SHC-ASTRA/biosensor-electrical/LANCE/LANCE.kicad_pcb

## KiCad design LANCE/LANCE.kicad_pcb (2026-05-26)

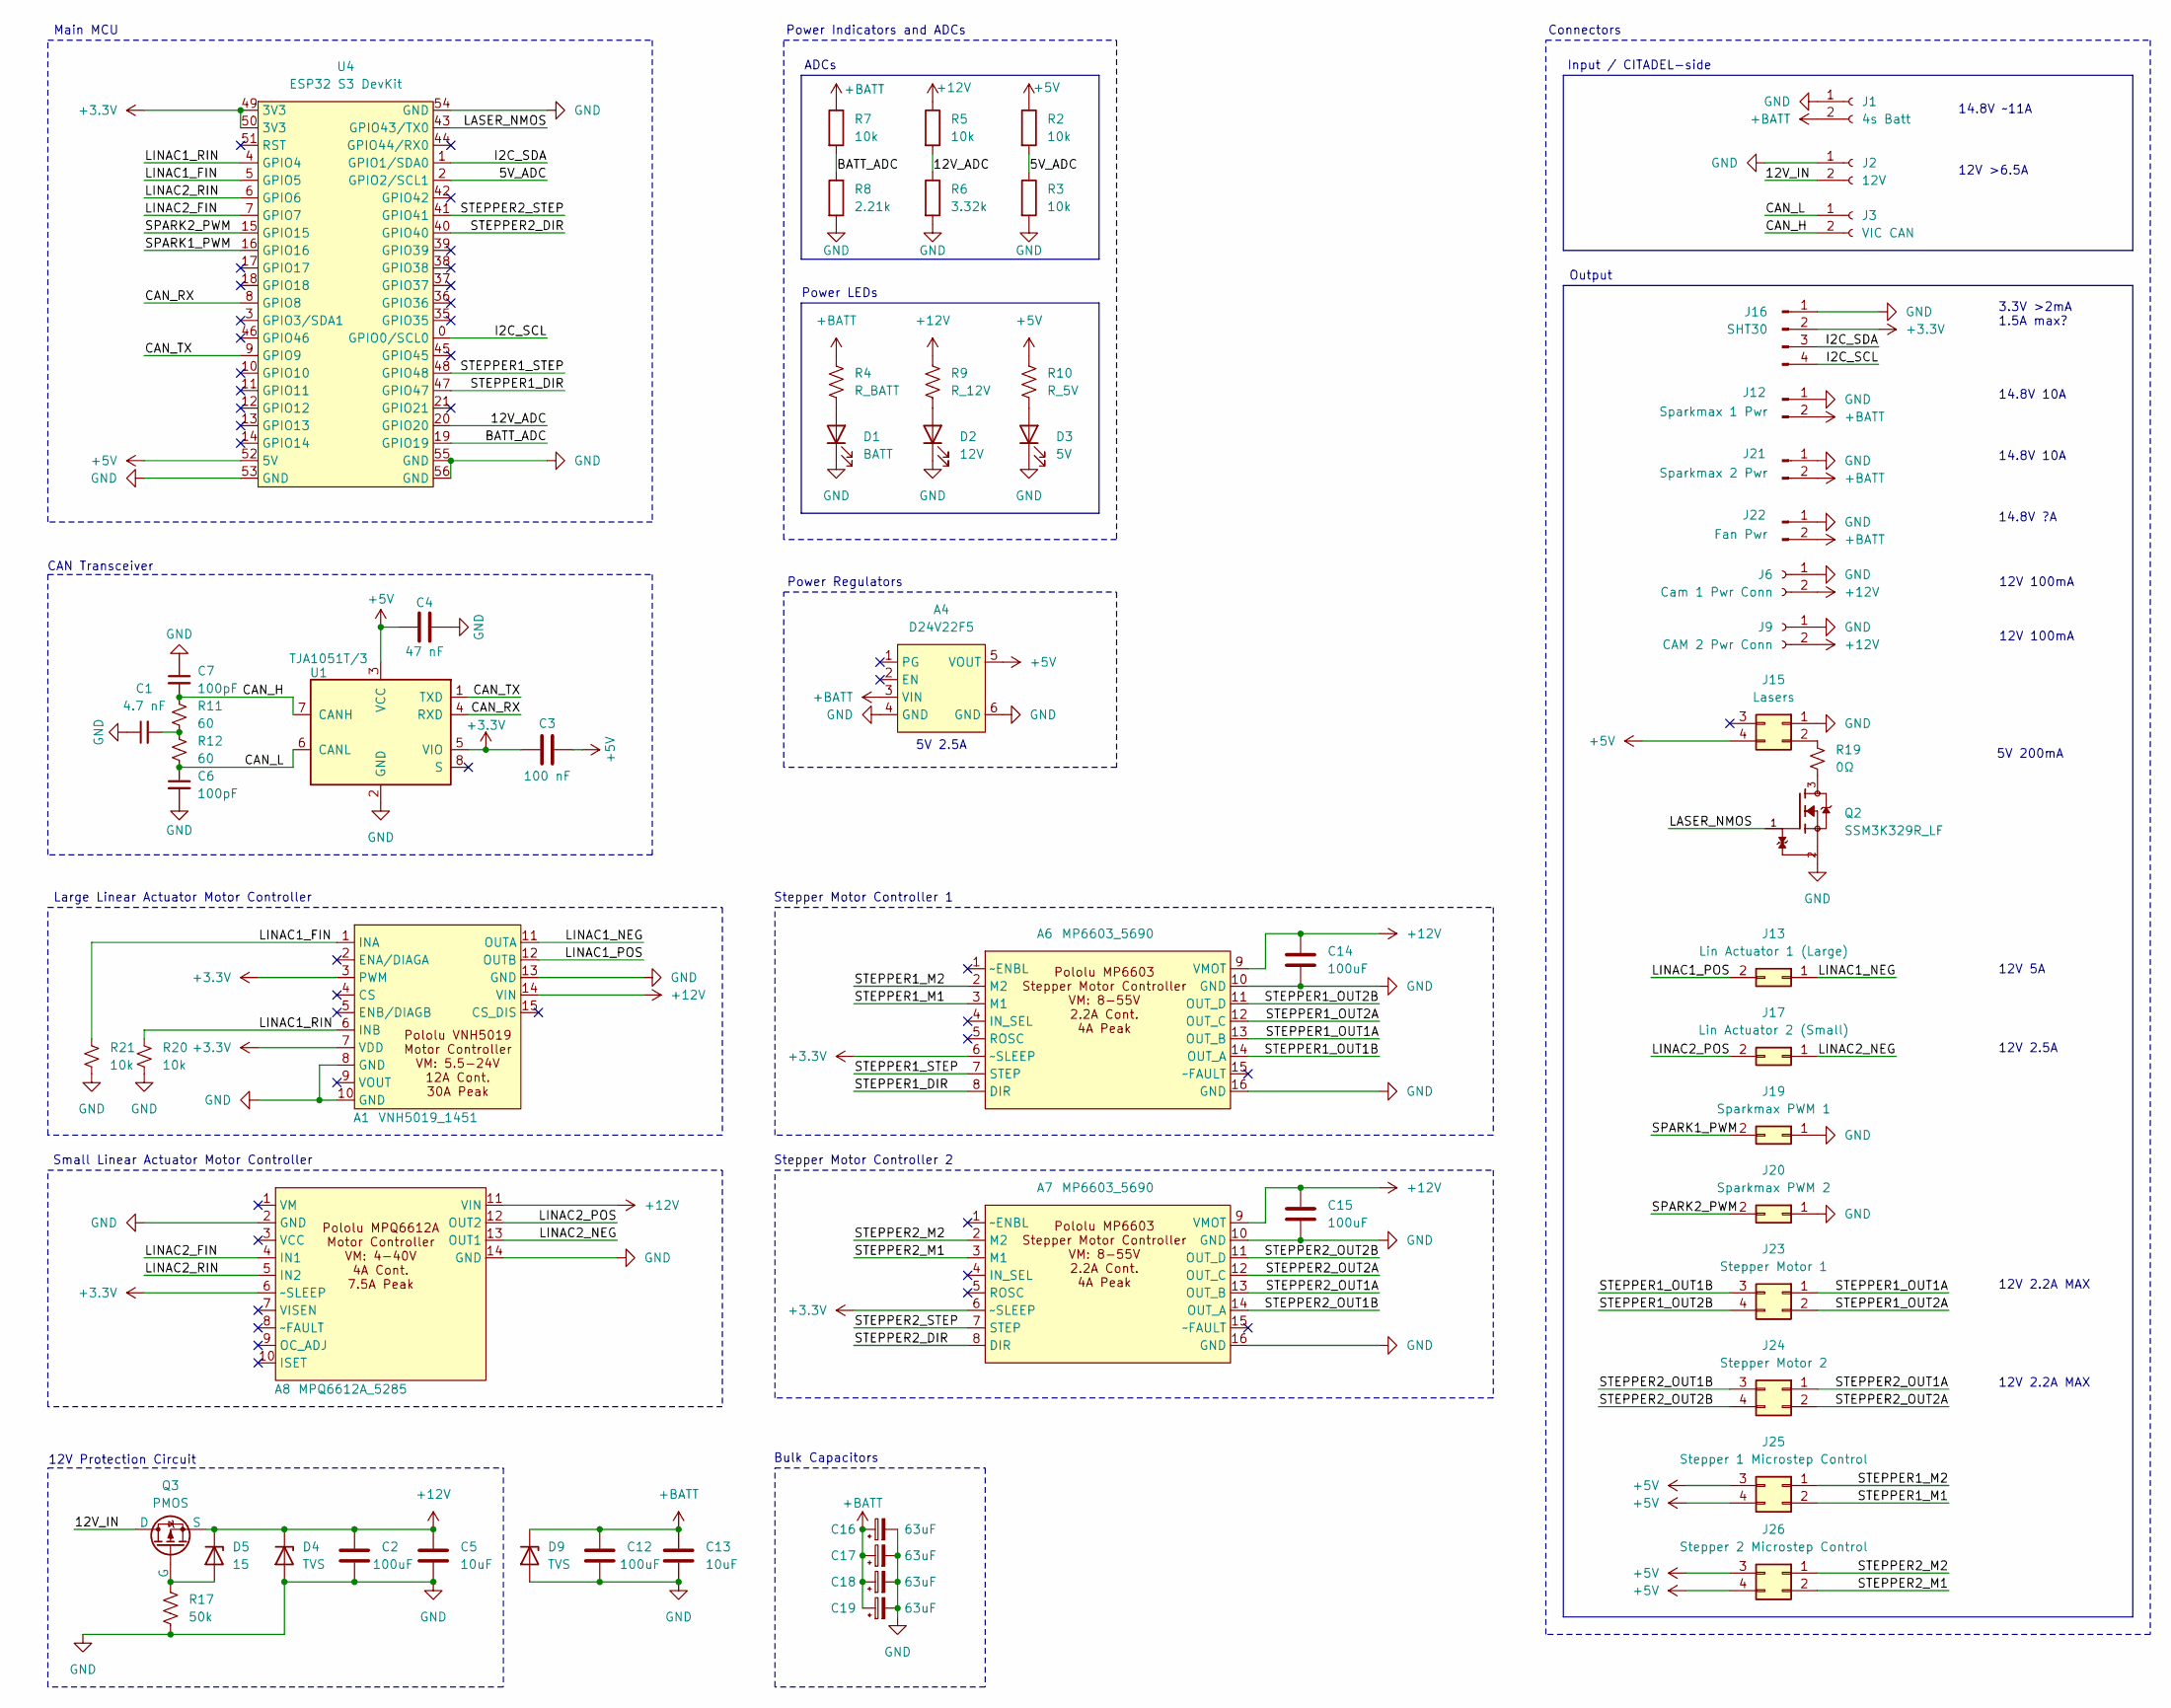
[picture p1: schematic LANCE.kicad_sch, LANCE 2026]

Parts:
A1: VNH5019_1451
A4: D24V22F5; D24V22Fx
A6, A7: MP6603_5690; MP6603-5690
A8: MPQ6612A_5285
C1: 4.7 nF; C_0603_1608Metric_Pad1.08x0.95mm_HandSolder
C2, C12, C14, C15: 100uF; C_1210_3225Metric_Pad1.33x2.70mm_HandSolder
C3: 100 nF; C_0603_1608Metric_Pad1.08x0.95mm_HandSolder
C4: 47 nF; C_0603_1608Metric_Pad1.08x0.95mm_HandSolder
C5, C13: 10uF; C_0603_1608Metric_Pad1.08x0.95mm_HandSolder
C6, C7: 100pF; C_0603_1608Metric_Pad1.08x0.95mm_HandSolder
C16, C17, C18, C19: 63uF; CP_Elec_6.3x7.7
D1: BATT; LED_0603_1608Metric_Pad1.05x0.95mm_HandSolder
D2: 12V; LED_0603_1608Metric_Pad1.05x0.95mm_HandSolder
D3: 5V; LED_0603_1608Metric_Pad1.05x0.95mm_HandSolder
D4, D9: TVS; SOD-323HEUS2H_TOS
D5: 15; D_SOD-123
J1: 4s Batt; AMASS_XT60PW-M_1x02_P7.20mm_Horizontal
J2: 12V; AMASS_XT30PW-M_1x02_P2.50mm_Horizontal
J3: VIC CAN; AMASS_XT30PW-F_1x02_P2.50mm_Horizontal
J6: Cam 1 Pwr Conn; AMASS_XT30U-F_1x02_P5.0mm_Vertical
J9: CAM 2 Pwr Conn; AMASS_XT30U-F_1x02_P5.0mm_Vertical
J12: Sparkmax 1 Pwr; AMASS_XT60PW-F_1x02_P7.20mm_Horizontal
J13: Lin Actuator 1 (Large); AMASS_XT30U-F_1x02_P5.0mm_Vertical
J15: Lasers; Molex_Mini-Fit_Jr_5566-04A_2x02_P4.20mm_Vertical
J16: SHT30; Molex_Mini-Fit_Jr_5566-04A_2x02_P4.20mm_Vertical
J17: Lin Actuator 2 (Small); AMASS_XT30U-F_1x02_P5.0mm_Vertical
J19: Sparkmax PWM 1; Molex_Mini-Fit_Jr_5566-02A_2x01_P4.20mm_Vertical
J20: Sparkmax PWM 2; Molex_Mini-Fit_Jr_5566-02A_2x01_P4.20mm_Vertical
J21: Sparkmax 2 Pwr; AMASS_XT60PW-F_1x02_P7.20mm_Horizontal
J22: Fan Pwr; AMASS_XT60PW-F_1x02_P7.20mm_Horizontal
J23: Stepper Motor 1; Molex_Mini-Fit_Jr_5566-04A_2x02_P4.20mm_Vertical
J24: Stepper Motor 2; Molex_Mini-Fit_Jr_5566-04A_2x02_P4.20mm_Vertical
J25: Stepper 1 Microstep Control; PinHeader_2x02_P2.54mm_Vertical
J26: Stepper 2 Microstep Control; PinHeader_2x02_P2.54mm_Vertical
Q2: SSM3K329R_LF; SOT-23F_TOS; PARTREV 1.0
Q3: PMOS; TO-252-2
R2, R3, R5, R7, R20, R21: 10k; R_0603_1608Metric_Pad0.98x0.95mm_HandSolder
R4: R_BATT; R_0603_1608Metric_Pad0.98x0.95mm_HandSolder
R6: 3.32k; R_0603_1608Metric_Pad0.98x0.95mm_HandSolder
R8: 2.21k; R_0603_1608Metric_Pad0.98x0.95mm_HandSolder
R9: R_12V; R_0603_1608Metric_Pad0.98x0.95mm_HandSolder
R10: R_5V; R_0603_1608Metric_Pad0.98x0.95mm_HandSolder
R11, R12: 60; R_0603_1608Metric_Pad0.98x0.95mm_HandSolder
R17: 50k; R_0603_1608Metric_Pad0.98x0.95mm_HandSolder
R19: 0Ω; R_0603_1608Metric_Pad0.98x0.95mm_HandSolder
U1: TJA1051T/3; SOIC-8_3.9x4.9mm_P1.27mm
U4: ESP32 S3 DevKit; ESP32-S3-DevKit_No_Keep-Out_Zone

Connections:
+3.3V: A1.3 (PWM), A1.7 (VDD), A6.6 (~SLEEP), A7.6 (~SLEEP), A8.6 (~SLEEP), C3.2, J16.2, U1.5 (VIO), U4.49 (3V3), U4.50 (3V3)
+5V: A4.5 (VOUT), C3.1, C4.1, J15.4, J25.3, J25.4, J26.3, J26.4, R2.1, R10.1, U1.3 (VCC), U4.52 (5V)
+12V: A1.14 (VIN), A6.9 (VMOT), A7.9 (VMOT), A8.11 (VIN), C2.1, C5.1, C14.1, C15.1, D4.1 (K), D5.1 (K), J6.2, J9.2, Q3.3 (S), R5.1, R9.1
+BATT: A4.3 (VIN), C12.1, C13.1, C16.1, C17.1, C18.1, C19.1, D9.1 (K), J1.2, J12.2, J21.2, J22.2, R4.1, R7.1
/5V_ADC: R2.2, R3.1, U4.2 (GPIO2/SCL1)
/12V_ADC: R5.2, R6.1, U4.20 (GPIO20)
/12V_IN: J2.2, Q3.1 (D)
/BATT_ADC: R7.2, R8.1, U4.19 (GPIO19)
/CAN_H: C7.2, J3.2, R11.1, U1.7 (CANH)
/CAN_L: C6.1, J3.1, R12.2, U1.6 (CANL)
/CAN_RX: U1.4 (RXD), U4.8 (GPIO8)
/CAN_TX: U1.1 (TXD), U4.9 (GPIO9)
/I2C_SCL: J16.4, U4.0 (GPIO0/SCL0)
/I2C_SDA: J16.3, U4.1 (GPIO1/SDA0)
/LASER_NMOS: Q2.1, U4.43 (GPIO43/TX0)
/LINAC1_FIN: A1.1 (INA), R21.2, U4.5 (GPIO5)
/LINAC1_NEG: A1.11 (OUTA), J13.1
/LINAC1_POS: A1.12 (OUTB), J13.2
/LINAC1_RIN: A1.6 (INB), R20.2, U4.4 (GPIO4)
/LINAC2_FIN: A8.4 (IN1), U4.7 (GPIO7)
/LINAC2_NEG: A8.13 (OUT1), J17.1
/LINAC2_POS: A8.12 (OUT2), J17.2
/LINAC2_RIN: A8.5 (IN2), U4.6 (GPIO6)
/SPARK1_PWM: J19.2, U4.16 (GPIO16)
/SPARK2_PWM: J20.2, U4.15 (GPIO15)
/STEPPER1_DIR: A6.8 (DIR), U4.47 (GPIO47)
/STEPPER1_M1: A6.3 (M1), J25.2
/STEPPER1_M2: A6.2 (M2), J25.1
/STEPPER1_OUT1A: A6.13 (OUT_B), J23.1
/STEPPER1_OUT1B: A6.14 (OUT_A), J23.3
/STEPPER1_OUT2A: A6.12 (OUT_C), J23.2
/STEPPER1_OUT2B: A6.11 (OUT_D), J23.4
/STEPPER1_STEP: A6.7 (STEP), U4.48 (GPIO48)
/STEPPER2_DIR: A7.8 (DIR), U4.40 (GPIO40)
/STEPPER2_M1: A7.3 (M1), J26.2
/STEPPER2_M2: A7.2 (M2), J26.1
/STEPPER2_OUT1A: A7.13 (OUT_B), J24.1
/STEPPER2_OUT1B: A7.14 (OUT_A), J24.3
/STEPPER2_OUT2A: A7.12 (OUT_C), J24.2
/STEPPER2_OUT2B: A7.11 (OUT_D), J24.4
/STEPPER2_STEP: A7.7 (STEP), U4.41 (GPIO41)
GND: A1.8 (GND), A1.10 (GND), A1.13 (GND), A4.4 (GND), A4.6 (GND), A6.10 (GND), A6.16 (GND), A7.10 (GND), A7.16 (GND), A8.2 (GND), A8.14 (GND), C1.1, C2.2, C4.2, C5.2, C6.2, C7.1, C12.2, C13.2, C14.2, C15.2, C16.2, C17.2, C18.2, C19.2, D1.1 (K), D2.1 (K), D3.1 (K), D4.2 (A), D9.2 (A), J1.1, J2.1, J6.1, J9.1, J12.1, J15.1, J16.1, J19.1, J20.1, J21.1, J22.1, Q2.2, R3.2, R6.2, R8.2, R17.2, R20.1, R21.1, U1.2 (GND), U4.53 (GND), U4.54 (GND), U4.55 (GND), U4.56 (GND)
unnamed: C1.2, R11.2, R12.1
unnamed: D1.2 (A), R4.2
unnamed: D2.2 (A), R9.2
unnamed: D3.2 (A), R10.2
unnamed: D5.2 (A), Q3.2 (G), R17.1
unnamed: J15.2, R19.1
unnamed: Q2.3, R19.2

Notes on the sheet:
Input / CITADEL-side
12V 5A
Power Regulators
14.8V 10A
ADCs
12V Protection Circuit
5V 2.5A
3.3V >2mA 1.5A max?
14.8V ~11A
Large Linear Actuator Motor Controller
12V 100mA
CAN Transceiver
Stepper Motor Controller 1
12V >6.5A
Stepper Motor Controller 2
Power LEDs
5V 200mA
Main MCU
14.8V ?A
Small Linear Actuator Motor Controller
12V 2.2A MAX
Power Indicators and ADCs
Output
Bulk Capacitors
Connectors
12V 2.5A

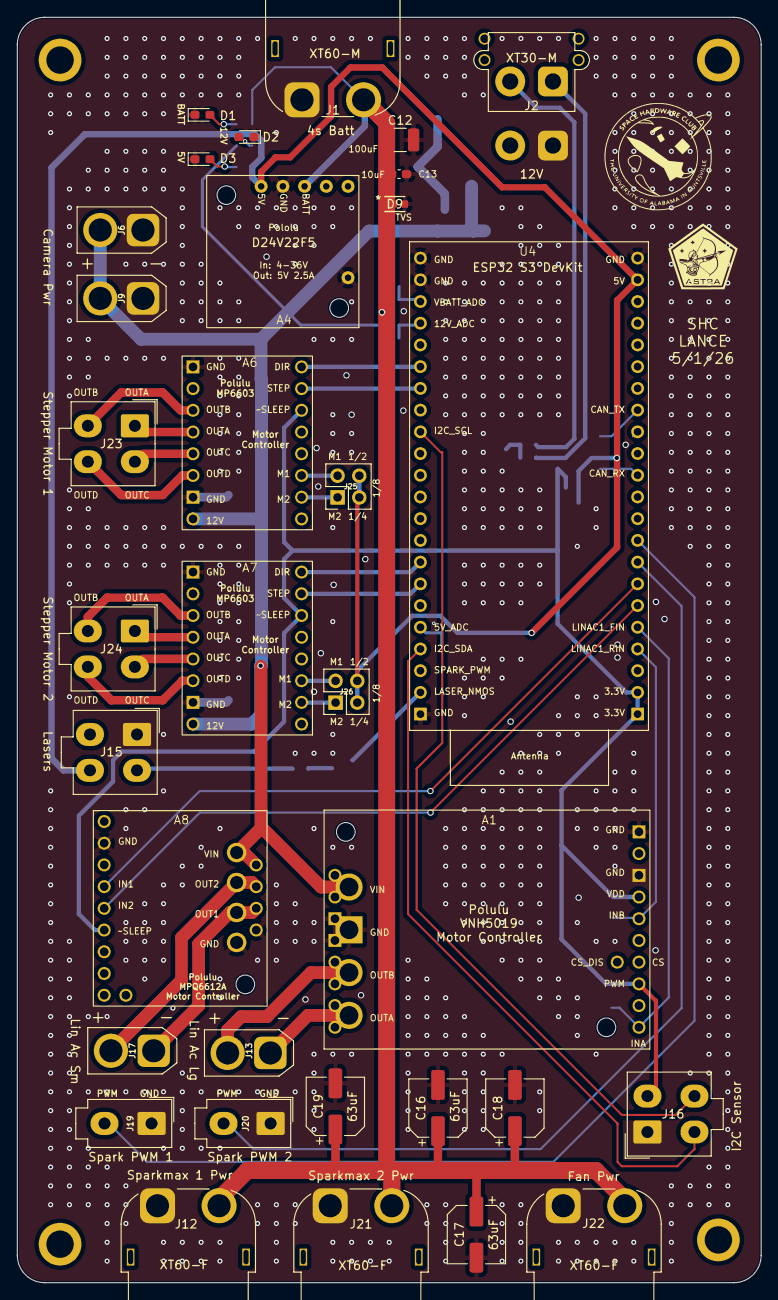
[picture p2: board LANCE.kicad_pcb from above]

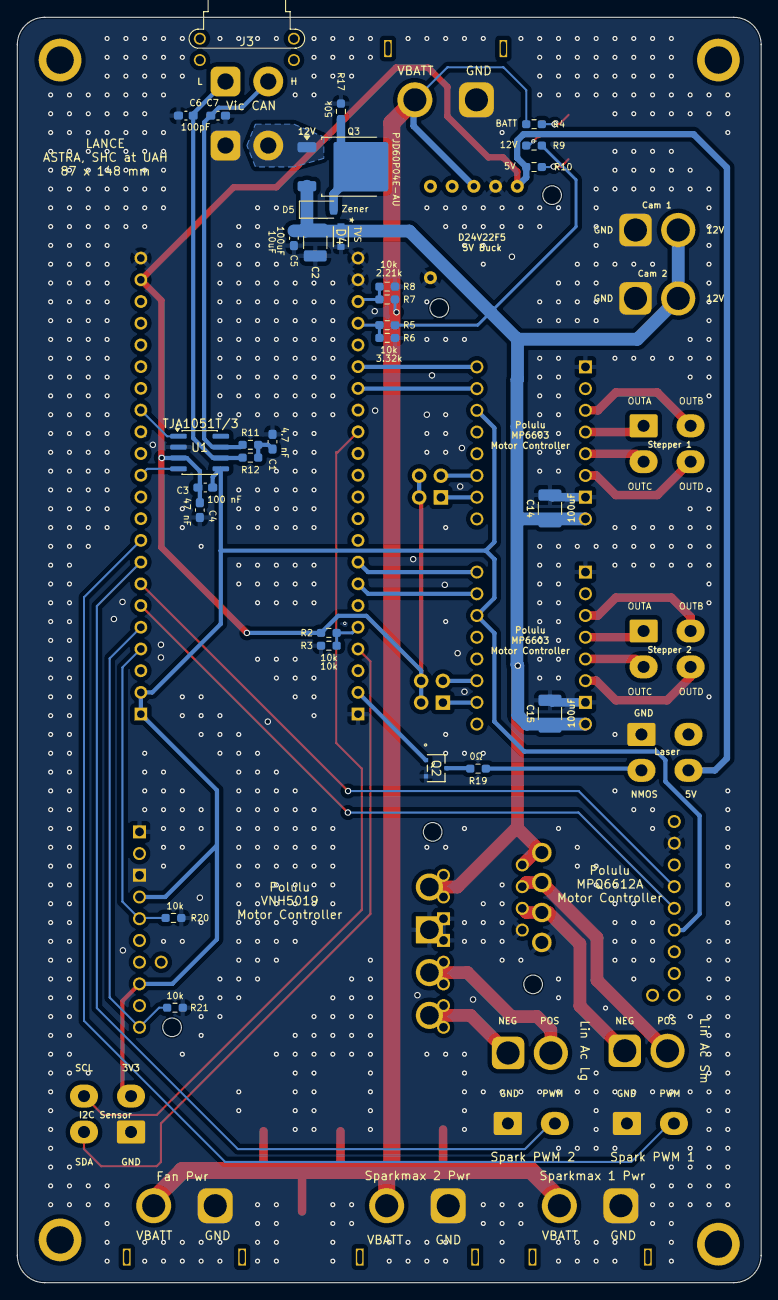
[picture p3: board LANCE.kicad_pcb from below]

Board: 2 copper layers, 87.0 x 148.0 mm, 63 parts (30 on the bottom side), 49 nets.
