SHC-ASTRA/biosensor-electrical/CITADEL/CITADEL 2026/CITADEL 2026 V2/CITADEL 2026 V2.kicad_pcb

## KiCad design CITADEL/CITADEL 2026/CITADEL 2026 V2/CITADEL 2026 V2.kicad_pcb (2026-03-25)

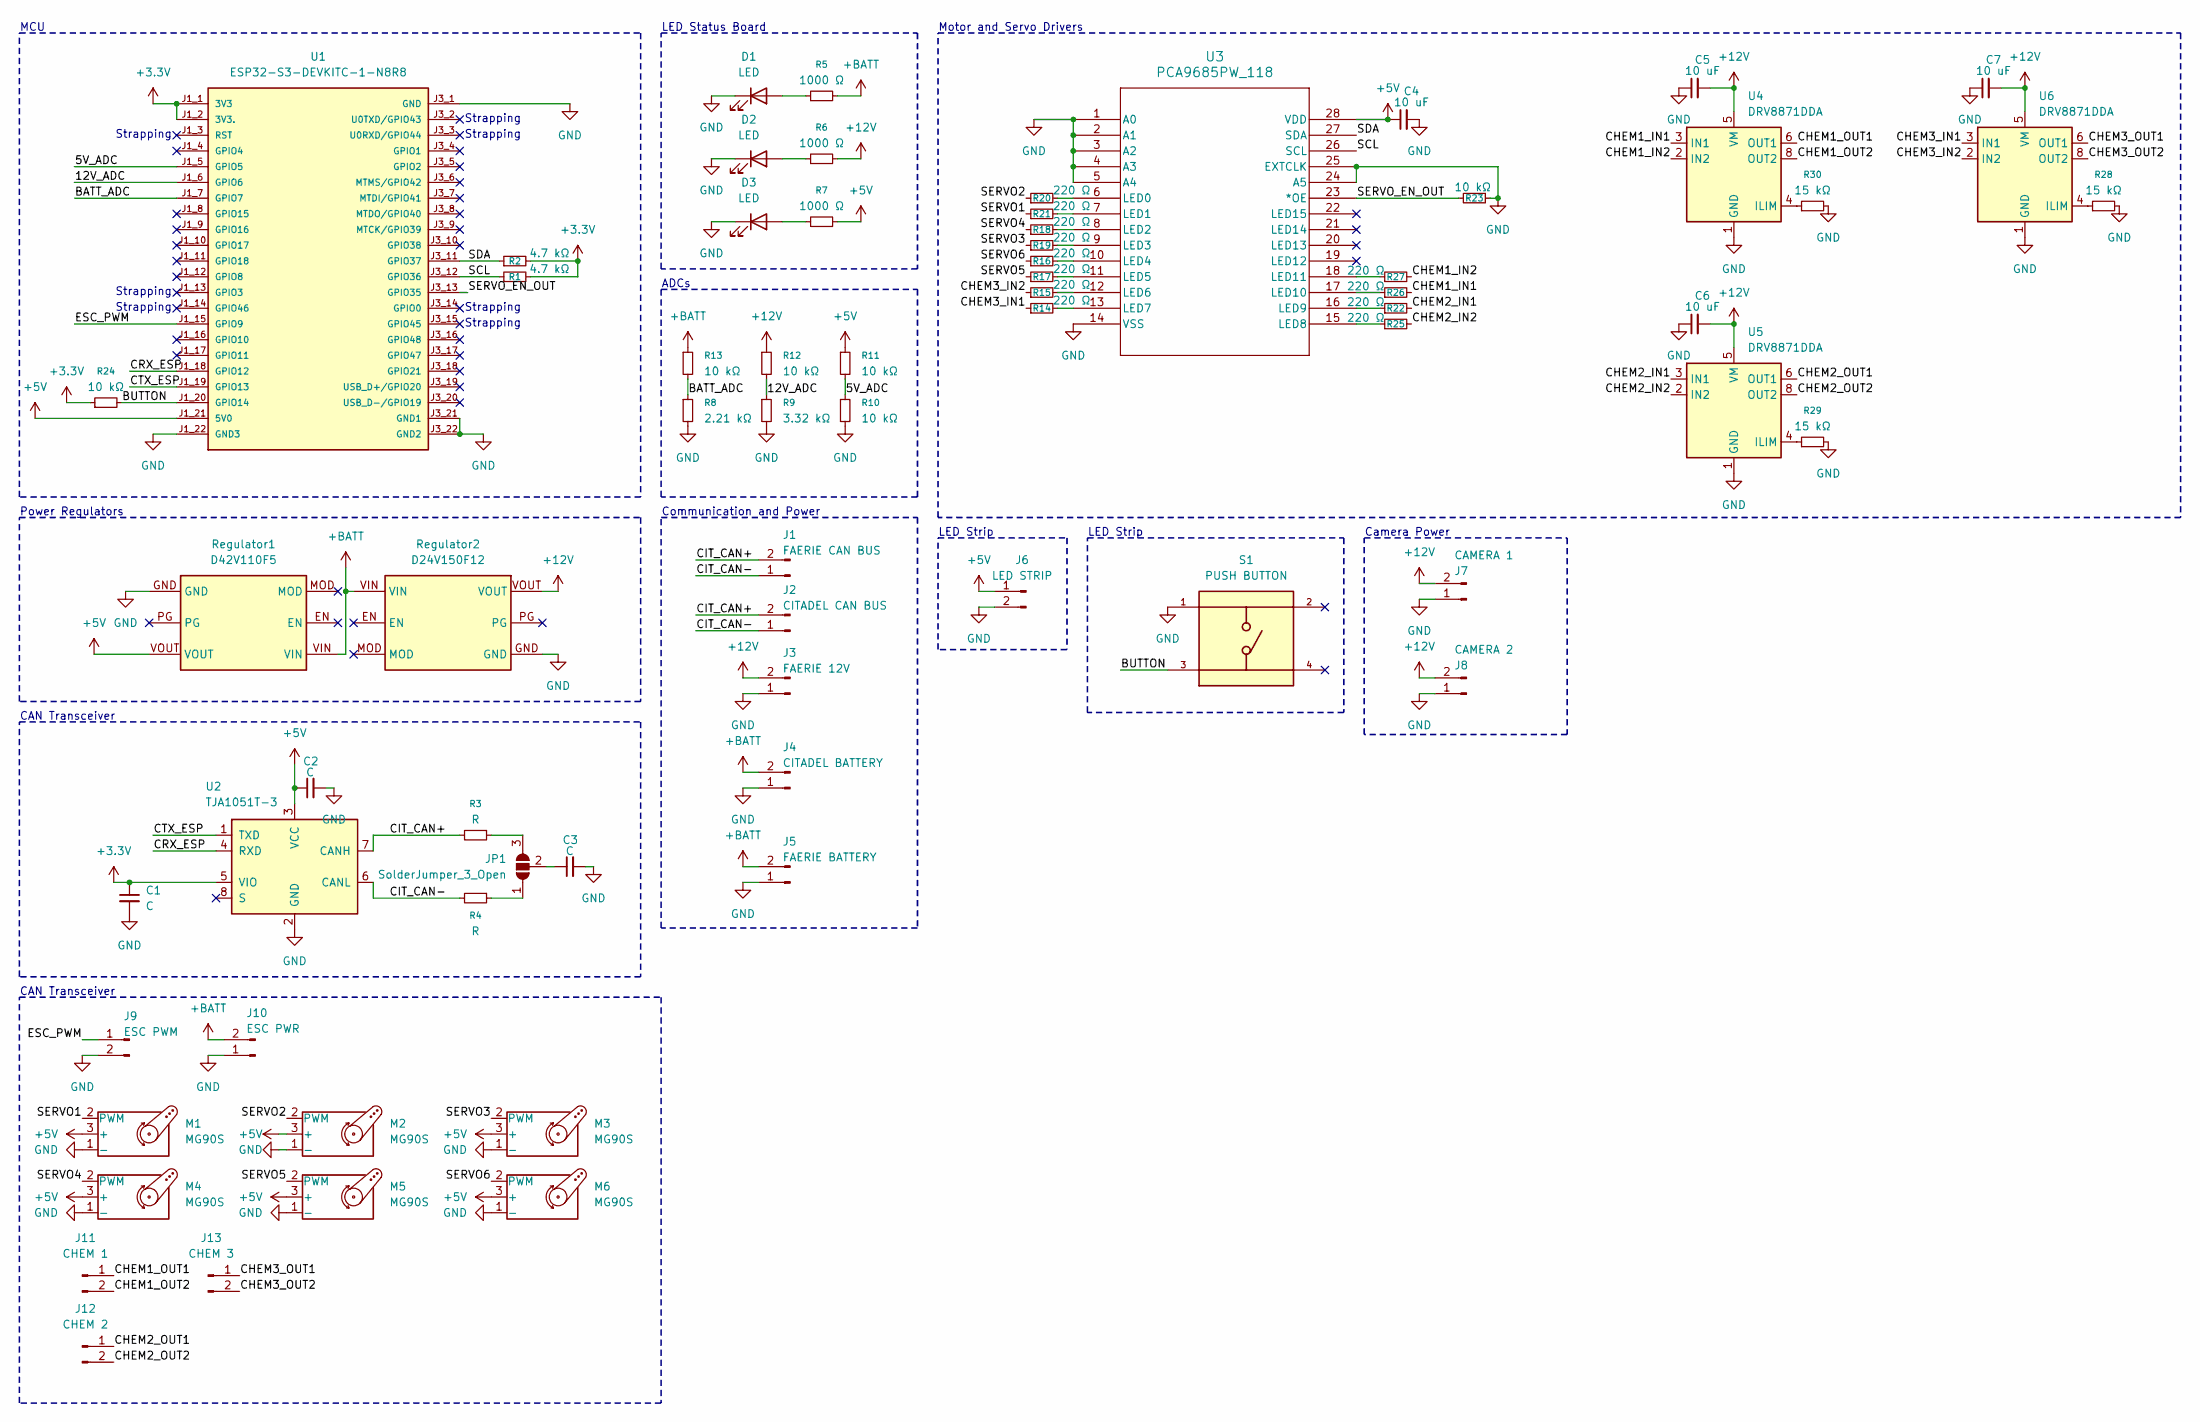
[picture p4: schematic CITADEL 2026 V2.kicad_sch, CITADEL]

Parts:
C1, C2, C3: C; C_0603_1608Metric_Pad1.08x0.95mm_HandSolder
C4, C5, C6, C7: 10 uF; C_0603_1608Metric
D1, D2, D3: LED; LED_D3.0mm
J1: FAERIE CAN BUS; AMASS_XT30U-M_1x02_P5.0mm_Vertical
J2: CITADEL CAN BUS; AMASS_XT30U-F_1x02_P5.0mm_Vertical
J3: FAERIE 12V; AMASS_XT30U-F_1x02_P5.0mm_Vertical
J4: CITADEL BATTERY; AMASS_XT60-M_1x02_P7.20mm_Vertical
J5: FAERIE BATTERY; AMASS_XT60-F_1x02_P7.20mm_Vertical
J6: LED STRIP; JST_XH_B2B-XH-A_1x02_P2.50mm_Vertical
J7: CAMERA 1; AMASS_XT30U-F_1x02_P5.0mm_Vertical
J8: CAMERA 2; AMASS_XT30U-F_1x02_P5.0mm_Vertical
J9: ESC PWM; JST_XH_B2B-XH-A_1x02_P2.50mm_Vertical
J10: ESC PWR; AMASS_XT60-F_1x02_P7.20mm_Vertical
J11: CHEM 1; Molex_Mini-Fit_Jr_5566-02A_2x01_P4.20mm_Vertical
J12: CHEM 2; Molex_Mini-Fit_Jr_5566-02A_2x01_P4.20mm_Vertical
J13: CHEM 3; Molex_Mini-Fit_Jr_5566-02A_2x01_P4.20mm_Vertical
JP1: SolderJumper_3_Open; SolderJumper-3_P1.3mm_Open_Pad1.0x1.5mm
M1, M2, M3, M4, M5, M6: MG90S; Molex_Mini-Fit_Jr_5566-04A_2x02_P4.20mm_Vertical
R1, R2: 4.7 kΩ; R_0603_1608Metric
R3, R4: R; R_0603_1608Metric
R5, R6, R7: 1000 Ω; R_0603_1608Metric
R8: 2.21 kΩ; R_0603_1608Metric
R9: 3.32 kΩ; R_0603_1608Metric
R10, R11, R12, R13, R23, R24: 10 kΩ; R_0603_1608Metric
R14, R15, R16, R17, R18, R19, R20, R21, R22, R25, R26, R27: 220 Ω; R_0603_1608Metric
R28, R29, R30: 15 kΩ; R_0603_1608Metric
Regulator1: D42V110F5; D24V15OF5
Regulator2: D24V150F12; D24V15OF5
S1: PUSH BUTTON; SW_TS02-66-60-BK-100-SCR-D; PARTREV 1.0
U1: ESP32-S3-DEVKITC-1-N8R8
U2: TJA1051T-3; SOIC-8_3.9x4.9mm_P1.27mm
U3: PCA9685PW_118; TSSOP28_SOT361-1_NXP
U4, U5, U6: DRV8871DDA; Texas_HTSOP-8-1EP_3.9x4.9mm_P1.27mm_EP2.95x4.9mm_Mask2.4x3.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

Connections:
+3.3V: C1.1, R1.2, R2.2, R24.1, U1.J1_1 (3V3), U1.J1_2 (3V3.), U2.5 (VIO)
+5V: C2.1, C4.1, J6.1, M1.3 (+), M1.4 (+), M2.3 (+), M2.4 (+), M3.3 (+), M3.4 (+), M4.3 (+), M4.4 (+), M5.3 (+), M5.4 (+), M6.3 (+), M6.4 (+), R7.2, R11.1, Regulator1.VOUT, U1.J1_21 (5V0), U2.3 (VCC), U3.28 (VDD)
+12V: C5.2, C6.2, C7.2, J3.2, J7.2, J8.2, R6.2, R12.1, Regulator2.VOUT, U4.5 (VM), U5.5 (VM), U6.5 (VM)
+BATT: J4.2, J5.2, J10.2, R5.2, R13.1, Regulator1.VIN, Regulator2.VIN
/5V_ADC: R10.1, R11.2, U1.J1_5 (GPIO5)
/12V_ADC: R9.1, R12.2, U1.J1_6 (GPIO6)
/BATT_ADC: R8.1, R13.2, U1.J1_7 (GPIO7)
/BUTTON: R24.2, S1.3, U1.J1_20 (GPIO14)
/CHEM1_IN1: R26.2, U4.3 (IN1)
/CHEM1_IN2: R27.2, U4.2 (IN2)
/CHEM1_OUT1: J11.1, U4.6 (OUT1)
/CHEM1_OUT2: J11.2, U4.8 (OUT2)
/CHEM2_IN1: R22.2, U5.3 (IN1)
/CHEM2_IN2: R25.2, U5.2 (IN2)
/CHEM2_OUT1: J12.1, U5.6 (OUT1)
/CHEM2_OUT2: J12.2, U5.8 (OUT2)
/CHEM3_IN1: R14.1, U6.3 (IN1)
/CHEM3_IN2: R15.1, U6.2 (IN2)
/CHEM3_OUT1: J13.1, U6.6 (OUT1)
/CHEM3_OUT2: J13.2, U6.8 (OUT2)
/CIT_CAN+: J1.2, J2.2, R3.2, U2.7 (CANH)
/CIT_CAN-: J1.1, J2.1, R4.2, U2.6 (CANL)
/CRX_ESP: U1.J1_18 (GPIO12), U2.4 (RXD)
/CTX_ESP: U1.J1_19 (GPIO13), U2.1 (TXD)
/ESC_PWM: J9.1, U1.J1_15 (GPIO9)
/SCL: R1.1, U1.J3_12 (GPIO36), U3.26 (SCL)
/SDA: R2.1, U1.J3_11 (GPIO37), U3.27 (SDA)
/SERVO1: M1.2 (PWM), R21.1
/SERVO2: M2.2 (PWM), R20.1
/SERVO3: M3.2 (PWM), R19.1
/SERVO4: M4.2 (PWM), R18.1
/SERVO5: M5.2 (PWM), R17.1
/SERVO6: M6.2 (PWM), R16.1
/SERVO_EN_OUT: R23.2, U1.J3_13 (GPIO35), U3.23 (*OE)
GND: C1.2, C2.2, C3.2, C4.2, C5.1, C6.1, C7.1, D1.1 (K), D2.1 (K), D3.1 (K), J3.1, J4.1, J5.1, J6.2, J7.1, J8.1, J9.2, J10.1, M1.1 (-), M2.1 (-), M3.1 (-), M4.1 (-), M5.1 (-), M6.1 (-), R8.2, R9.2, R10.2, R23.1, R28.2, R29.2, R30.2, Regulator1.GND, Regulator2.GND, S1.1, U1.J1_22 (GND3), U1.J3_1 (GND), U1.J3_21 (GND1), U1.J3_22 (GND2), U2.2 (GND), U3.1 (A0), U3.2 (A1), U3.3 (A2), U3.4 (A3), U3.5 (A4), U3.14 (VSS), U3.24 (A5), U3.25 (EXTCLK), U4.1 (GND), U4.7 (GND), U4.9 (GND), U5.1 (GND), U5.7 (GND), U5.9 (GND), U6.1 (GND), U6.7 (GND), U6.9 (GND)
unnamed: D1.2 (A), R5.1
unnamed: D2.2 (A), R6.1
unnamed: D3.2 (A), R7.1
unnamed: JP1.1 (A), R4.1
unnamed: JP1.3 (B), R3.1
unnamed: C3.1, JP1.2 (C)
unnamed: R20.2, U3.6 (LED0)
unnamed: R21.2, U3.7 (LED1)
unnamed: R18.2, U3.8 (LED2)
unnamed: R19.2, U3.9 (LED3)
unnamed: R16.2, U3.10 (LED4)
unnamed: R17.2, U3.11 (LED5)
unnamed: R15.2, U3.12 (LED6)
unnamed: R14.2, U3.13 (LED7)
unnamed: R25.1, U3.15 (LED8)
unnamed: R22.1, U3.16 (LED9)
unnamed: R26.1, U3.17 (LED10)
unnamed: R27.1, U3.18 (LED11)
unnamed: R30.1, U4.4 (ILIM)
unnamed: R29.1, U5.4 (ILIM)
unnamed: R28.1, U6.4 (ILIM)

Notes on the sheet:
CAN Transceiver
Motor and Servo Drivers
Strapping
Camera Power
MCU
ADCs
LED Status Board
Power Regulators
Communication and Power
LED Strip

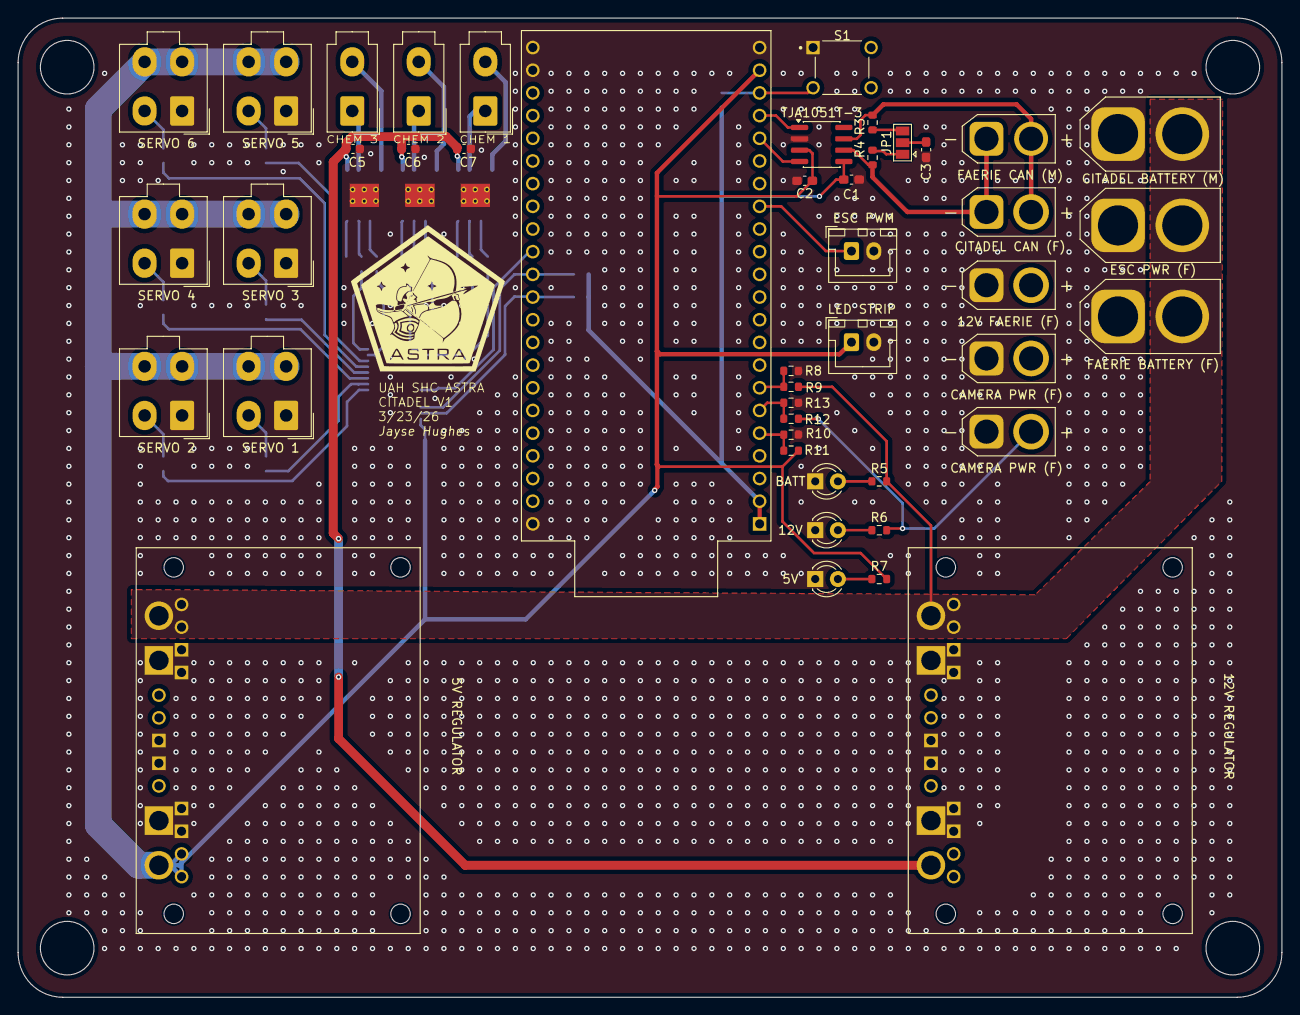
[picture p5: board CITADEL 2026 V2.kicad_pcb from above]

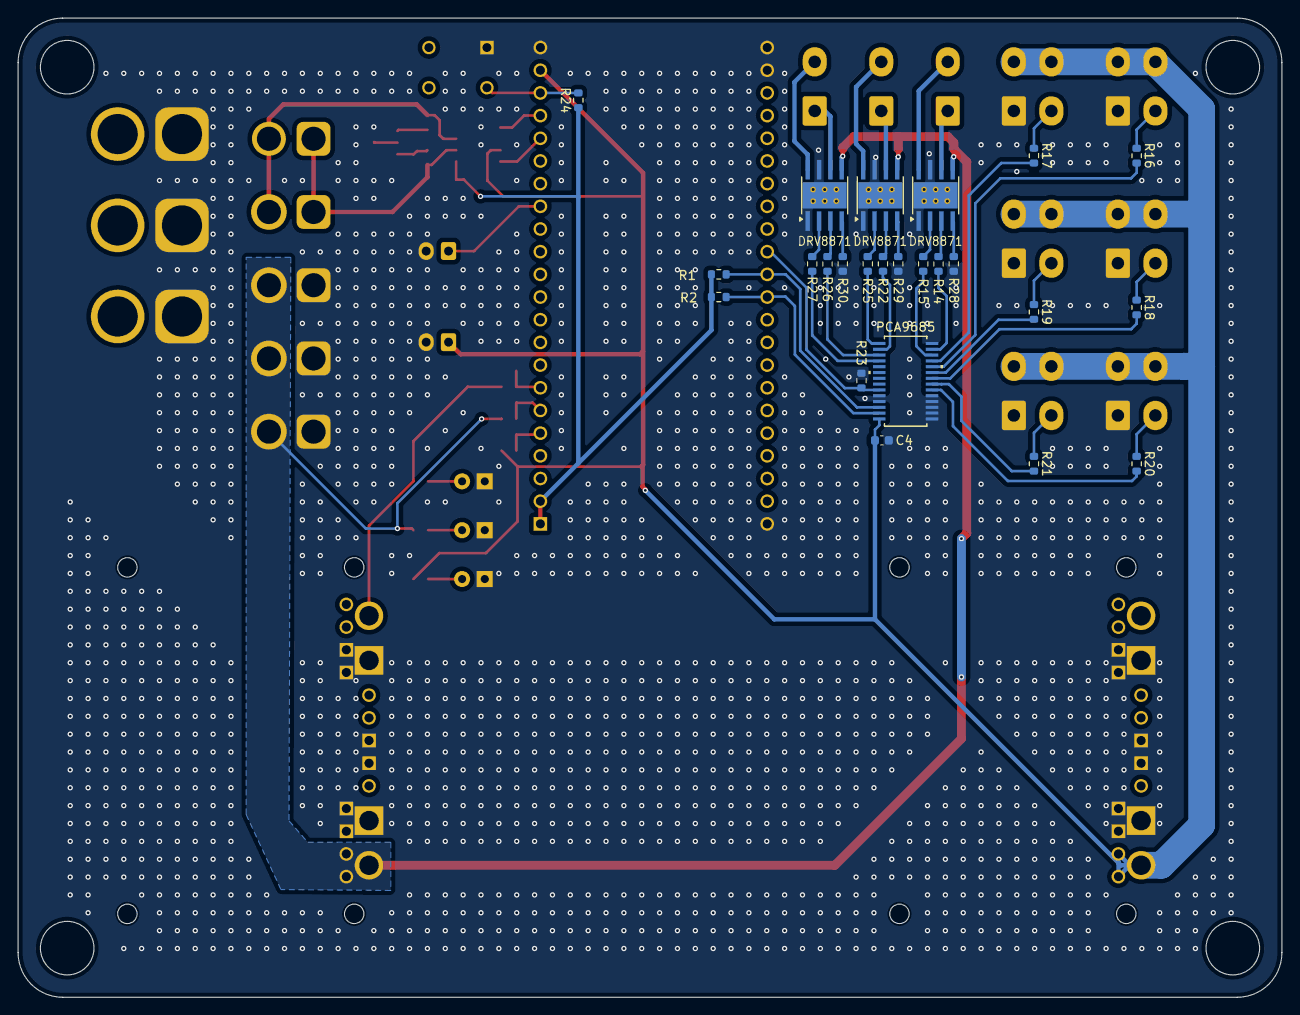
[picture p6: board CITADEL 2026 V2.kicad_pcb from below]

Board: 2 copper layers, 141.5 x 109.7 mm, 69 parts (24 on the bottom side), 56 nets.
