SHC-ASTRA/biosensor-electrical/CITADEL/CITADEL 2026/CITADEL 2026 V1/CITADEL 2026.kicad_pcb

## KiCad design CITADEL/CITADEL 2026/CITADEL 2026 V1/CITADEL 2026.kicad_pcb (2026-02-11, an earlier design)

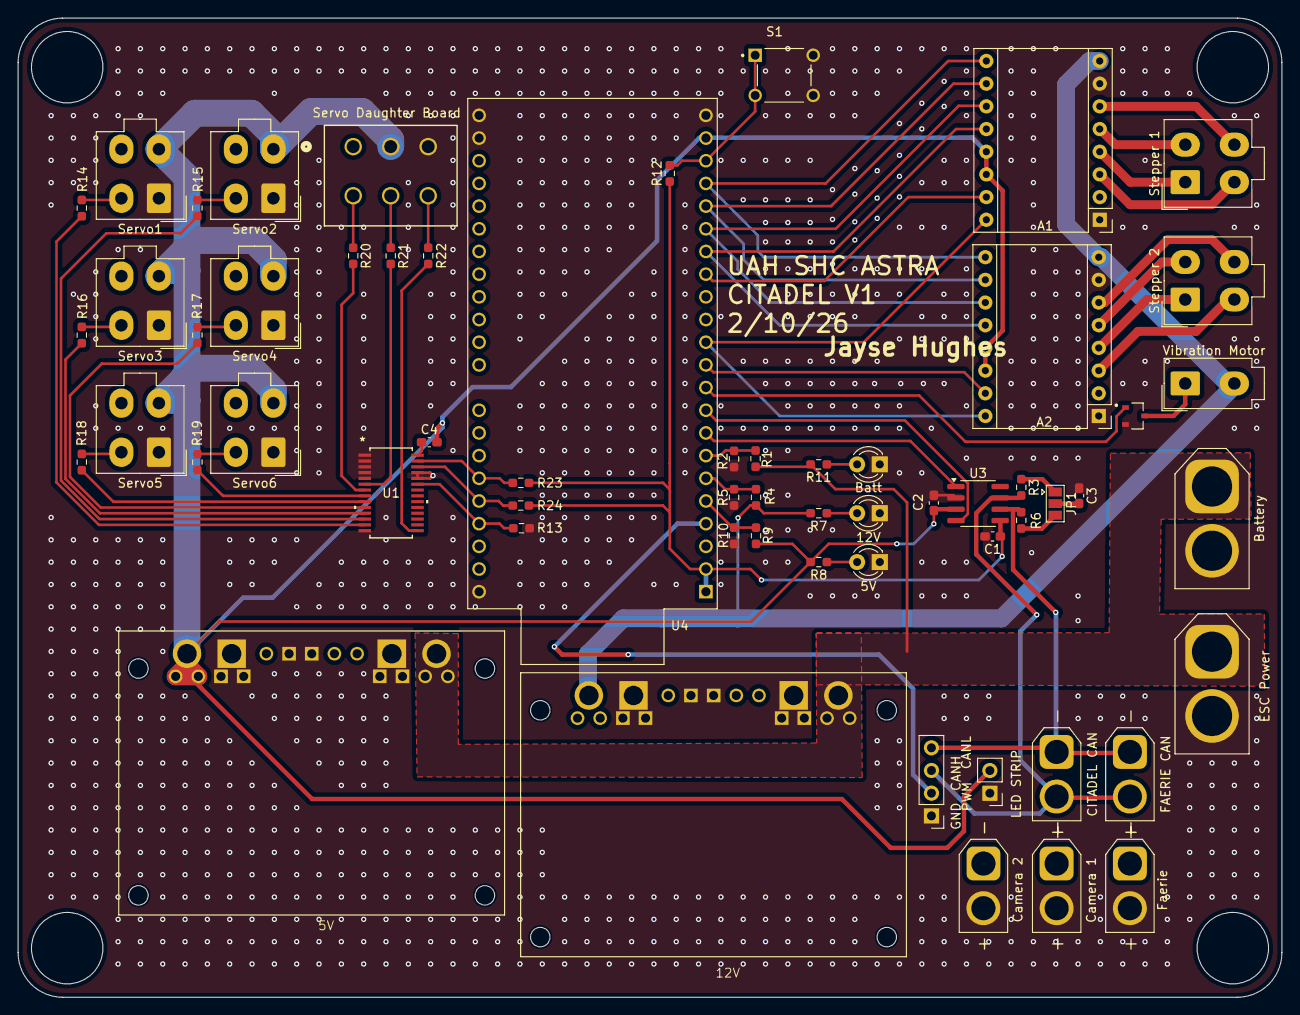
[picture p7: board CITADEL 2026.kicad_pcb from above]

Board: 2 copper layers, 141.5 x 109.7 mm, 60 parts (0 on the bottom side), 59 nets.

Parts:
5V, 12V: LED; LED_D3.0mm
5V#2: PS1; D24V15OF5
12V#2: PS2; D24V15OF5
A1, A2: Pololu_Breakout_DRV8825; Pololu_Breakout-16_15.2x20.3mm
Batt: LED; LED_D3.0mm
Battery: Battery Connections; AMASS_XT60-M_1x02_P7.20mm_Vertical
C1, C2, C3: C; C_0603_1608Metric_Pad1.08x0.95mm_HandSolder
C4: 10uF; C_0603_1608Metric_Pad1.08x0.95mm_HandSolder
CITADEL CAN: CAN BUS; AMASS_XT30U-M_1x02_P5.0mm_Vertical
Camera 1: Camera 1; AMASS_XT30U-M_1x02_P5.0mm_Vertical
Camera 2: Camera 2; AMASS_XT30U-M_1x02_P5.0mm_Vertical
ESC Power: ESC PWR; AMASS_XT60-M_1x02_P7.20mm_Vertical
FAERIE CAN: Faerie CAN BUS; AMASS_XT30U-M_1x02_P5.0mm_Vertical
Faerie: Faerie; AMASS_XT30U-M_1x02_P5.0mm_Vertical
GND: ESC Comms; PinHeader_1x04_P2.54mm_Vertical
JP1: SolderJumper_3_Open; SolderJumper-3_P1.3mm_Open_Pad1.0x1.5mm
LED STRIP: LED Strip; PinHeader_1x02_P2.54mm_Vertical
Q7: SSM3K329R_LF; SSM3K329_LF
R1, R4, R9, R10, R12: 10 kΩ; R_0603_1608Metric_Pad0.98x0.95mm_HandSolder
R2: 2.21 kΩ; R_0603_1608Metric_Pad0.98x0.95mm_HandSolder
R3, R6: R_US; R_0603_1608Metric_Pad0.98x0.95mm_HandSolder
R5: 3.32 kΩ; R_0603_1608Metric_Pad0.98x0.95mm_HandSolder
R7, R8, R11: 1000; R_0603_1608Metric_Pad0.98x0.95mm_HandSolder
R13: 10kΩ; R_0603_1608Metric_Pad0.98x0.95mm_HandSolder
R14, R15, R16, R17, R18, R19, R20, R21, R22: 220Ω; R_0603_1608Metric_Pad0.98x0.95mm_HandSolder
R23, R24: 4.7 kΩ; R_0603_1608Metric_Pad0.98x0.95mm_HandSolder
S1: Push Button; SW_TS02-66-60-BK-100-SCR-D
Servo1: MG90S 1; Molex_Mini-Fit_Jr_5566-04A_2x02_P4.20mm_Vertical
Servo2: MG90S 2; Molex_Mini-Fit_Jr_5566-04A_2x02_P4.20mm_Vertical
Servo3: MG90S 3; Molex_Mini-Fit_Jr_5566-04A_2x02_P4.20mm_Vertical
Servo4: MG90S 4; Molex_Mini-Fit_Jr_5566-04A_2x02_P4.20mm_Vertical
Servo5: MG90S 5; Molex_Mini-Fit_Jr_5566-04A_2x02_P4.20mm_Vertical
Servo6: MG90S 6; Molex_Mini-Fit_Jr_5566-04A_2x02_P4.20mm_Vertical
Servo Daughter Board: Servo_Daughter; CONN_SD-5566-002_06_MOL
Stepper 1: Stepper 1; Molex_Mini-Fit_Jr_5566-04A_2x02_P4.20mm_Vertical
Stepper 2: Stepper 2; Molex_Mini-Fit_Jr_5566-04A_2x02_P4.20mm_Vertical
U1: PCA9685PW_118; TSSOP28_SOT361-1_NXP
U3: TJA1051T-3; SOIC-8_3.9x4.9mm_P1.27mm
U4: ESP32-S3-DEVKITC-1-N8R8
Vibration Motor: Vibration Motor; Molex_Mini-Fit_Jr_5566-02A_2x01_P4.20mm_Vertical

Connections:
+3.3V: C1.1, R12.1, R23.2, R24.2, U3.5 (VIO), U4.J1_1 (3V3), U4.J1_2 (3V3.)
+5V: 5V#2.VOUT, 5V#2.VOUT_1 (VOUT), 5V#2.VOUT_2 (VOUT), A1.13 (~RST), A1.14 (~SLP), A2.13 (~RST), A2.14 (~SLP), C2.2, C4.2, LED STRIP.2, R8.2, R9.1, Servo1.3 (+), Servo2.3 (+), Servo3.3 (+), Servo4.3 (+), Servo5.3 (+), Servo6.3 (+), Servo Daughter Board.2, U3.3 (VCC), U4.J1_21 (5V0)
+12V: 12V#2.VOUT, 12V#2.VOUT_1 (VOUT), 12V#2.VOUT_2 (VOUT), A1.8 (VMOT), A2.8 (VMOT), Camera 1.1, Camera 2.1, Faerie.1, R4.1, R7.2, Vibration Motor.2
+BATT: 5V#2.VIN, 5V#2.VIN_1 (VIN), 5V#2.VIN_2 (VIN), 12V#2.VIN, 12V#2.VIN_1 (VIN), 12V#2.VIN_2 (VIN), Battery.1, ESC Power.1, R1.1, R11.2
/5V_ADC: R9.2, R10.1, U4.J1_5 (GPIO5)
/12V_ADC: R4.2, R5.1, U4.J1_6 (GPIO6)
/BATT_ADC: R1.2, R2.1, U4.J1_7 (GPIO7)
/Button: R12.2, S1.1, S1.3, U4.J1_20 (GPIO14)
/CIT_CAN+: CITADEL CAN.2, FAERIE CAN.2, GND.3, R3.2, U3.7 (CANH)
/CIT_CAN-: CITADEL CAN.1, FAERIE CAN.1, GND.4, R6.2, U3.6 (CANL)
/CRX_ESP: U3.4 (RXD), U4.J1_9 (GPIO16)
/CTX_ESP: U3.1 (TXD), U4.J1_8 (GPIO15)
/ESC_PWM: GND.2, U4.J1_4 (GPIO4)
/Motor1_1: A1.4 (A1), Stepper 1.1
/Motor1_2: A1.3 (A2), Stepper 1.3
/Motor1_3: A1.5 (B1), Stepper 1.2
/Motor1_4: A1.6 (B2), Stepper 1.4
/Motor2_1: A2.4 (A1), Stepper 2.1
/Motor2_2: A2.3 (A2), Stepper 2.3
/Motor2_3: A2.5 (B1), Stepper 2.2
/Motor2_4: A2.6 (B2), Stepper 2.4
/SCL: R24.1, U1.26 (SCL), U4.J3_5 (GPIO2)
/SDA: R23.1, U1.27 (SDA), U4.J3_6 (MTMS/GPIO42)
/Servo1: R14.1, Servo1.2 (PWM)
/Servo2: R15.1, Servo2.2 (PWM)
/Servo3: R16.1, Servo3.2 (PWM)
/Servo4: R17.1, Servo4.2 (PWM)
/Servo5: R18.1, Servo5.2 (PWM)
/Servo6: R19.1, Servo6.2 (PWM)
/Servo7: R20.1, Servo Daughter Board.4
/Servo8: R21.1, Servo Daughter Board.5
/Servo9: R22.2, Servo Daughter Board.6
/Servo_Enable_Output: R13.1, U1.23 (*OE), U4.J3_4 (GPIO1)
/Stepper1_STEP: A1.15 (STEP), U4.J1_15 (GPIO9)
/Stepper2_STEP: A2.15 (STEP), U4.J1_11 (GPIO18)
/Stepper_DIR: A1.16 (DIR), A2.16 (DIR), U4.J1_12 (GPIO8)
/Stepper_EN: A1.9 (~EN), A2.9 (~EN), U4.J1_19 (GPIO13)
/Stepper_M0: A1.10 (M0), A2.10 (M0), U4.J1_18 (GPIO12)
/Stepper_M1: A1.11 (M1), A2.11 (M1), U4.J1_17 (GPIO11)
/Stepper_M2: A1.12 (M2), A2.12 (M2), U4.J1_16 (GPIO10)
/VibMotorMOS: Q7.3, Vibration Motor.1
/VibMotorSignal: Q7.1, U4.J1_10 (GPIO17)
GND: 5V.1 (K), 5V#2.GND, 5V#2.GND1 (GND), 5V#2.GND2 (GND), 5V#2.GND3 (GND), 5V#2.GND4 (GND), 5V#2.GND5 (GND), 5V#2.GND6 (GND), 5V#2.GND7 (GND), 12V.1 (K), 12V#2.GND, 12V#2.GND1 (GND), 12V#2.GND2 (GND), 12V#2.GND3 (GND), 12V#2.GND4 (GND), 12V#2.GND5 (GND), 12V#2.GND6 (GND), 12V#2.GND7 (GND), A1.1 (GND), A1.7 (GND), A2.1 (GND), A2.7 (GND), Batt.1 (K), Battery.2, C1.2, C2.1, C3.1, Camera 1.2, Camera 2.2, ESC Power.2, Faerie.2, GND.1, LED STRIP.1, Q7.2, R2.2, R5.2, R10.2, R13.2, S1.2, S1.4, Servo1.1 (-), Servo2.1 (-), Servo3.1 (-), Servo4.1 (-), Servo5.1 (-), Servo6.1 (-), Servo Daughter Board.3, U1.1 (A0), U1.2 (A1), U1.3 (A2), U1.4 (A3), U1.5 (A4), U1.14 (VSS), U1.24 (A5), U1.25 (EXTCLK), U3.2 (GND), U4.J1_22 (GND3), U4.J3_1 (GND), U4.J3_21 (GND1), U4.J3_22 (GND2)
unnamed: Batt.2 (A), R11.1
unnamed: 12V.2 (A), R7.1
unnamed: 5V.2 (A), R8.1
unnamed: JP1.3 (A), R6.1
unnamed: JP1.1 (B), R3.1
unnamed: C3.2, JP1.2 (C)
unnamed: R21.2, U1.6 (LED0)
unnamed: R20.2, U1.7 (LED1)
unnamed: R19.2, U1.8 (LED2)
unnamed: R18.2, U1.9 (LED3)
unnamed: R17.2, U1.10 (LED4)
unnamed: R16.2, U1.11 (LED5)
unnamed: R15.2, U1.12 (LED6)
unnamed: R14.2, U1.13 (LED7)
unnamed: R22.1, U1.15 (LED8)
unnamed: C4.1, U1.28 (VDD)
