SHC-ASTRA/biosensor-electrical/(commit log)

2025-12-13 CITADEL V1
    Sep 21, 2021; Thomas Bennett
    [adapter-shield.kicad_pcb, adapter-shield.sch, epc901-breakout.kicad_pcb, epc901-breakout.sch]
2025-12-13 CITADEL V2
    April 14, 2022; Thomas Bennett
    [adapter-shield.kicad_pcb, adapter-shield.sch]
2025-12-13 CITADEL 2023 V2
    March 10, 2023; it was still just called 'BioSensor' and they added a carousel system
    [BioSensor Fans.kicad_sch, BioSensor Serving Scoop.kicad_sch, BioSensor.kicad_pcb, BioSensor.kicad_sch, BioSensor.sch, adapter-shield.kicad_pcb, epc901-breakout.kicad_pcb, epc901-breakout.sch]
2025-12-13 CITADEL 2024 V2, FAERIE 2024 V2
    CITADEL January 17, 2024; FAERIE March 30, 2024; CITADEL was redesigned to be much simpler, FAERIE was introduced and designed by yours truly
    [BioSensor Fans.kicad_sch, BioSensor Serving Scoop.kicad_sch, BioSensor.kicad_pcb, BioSensor.kicad_sch, BioSensor.sch, Citadel.kicad_pcb, Citadel.kicad_sch, Citadel1.kicad_sch]
2025-12-13 CITADEL 2025 V1, FAERIE 2025 V1
    CITADEL January 27, 2025; FAERIE January 26, 2025; Katherine and Mason did CITADEL, Reymund did FAERIE
    [Citadel.kicad_pcb, Citadel.kicad_sch, Citadel1.kicad_sch, FAERIE.kicad_pcb, FAERIE.kicad_sch, Faerie.kicad_pcb, Faerie.kicad_sch]
2025-12-13 CITADEL 2025 V2
    April 8, 2025; replaced the second MCU with a GPIO extender IC that didn't end up working
    [Citadel.kicad_pcb, Citadel.kicad_sch]
2025-12-13 CITADEL 2025 V3
    May 11, 2025; got rid of the GPIO extender
    [Citadel.kicad_pcb, Citadel.kicad_sch]
2025-12-18 Started new CITADEL PCB
    [CITADEL 2026.kicad_pcb, CITADEL 2026.kicad_sch, Citadel.kicad_pcb, Citadel.kicad_sch]
2026-01-10 Updated Schematic
    [CITADEL 2026.kicad_sch]
2026-01-14 Updated Schematic
    Changed MCU, added additional connectors
    [CITADEL 2026.kicad_sch]
2026-01-14 Updated Schematic
    Changed motor drivers and connectors
    [CITADEL 2026.kicad_sch]
2026-01-16 Changed 5V buck from 15A to 11A
    [CITADEL 2026.kicad_sch]
2026-01-16 Added no connect flags
    [CITADEL 2026.kicad_sch]
2026-01-18 Started PCB V1
    [CITADEL 2026.kicad_pcb, CITADEL 2026.kicad_sch]
2026-01-19 Updated PCB V1
    [CITADEL 2026.kicad_pcb]
2026-01-22 Added camera connectors
    [CITADEL 2026.kicad_sch]
2026-01-23 Added camera connections
    [CITADEL 2026.kicad_pcb]
2026-01-24 Changed servo connectors, added connector for servo daughter board
    [CITADEL 2026.kicad_pcb, CITADEL 2026.kicad_sch]
2026-01-24 Created servo daughter board
    [CITADEL 2026 Daughter.kicad_pcb, CITADEL 2026 Daughter.kicad_sch]
2026-01-24 Changed board to be square
    [CITADEL 2026 Daughter.kicad_pcb]
2026-01-25 Added ASTRA logo
    [CITADEL 2026.kicad_pcb]
2026-01-26 Fixed typo with stepper connectors
    [CITADEL 2026.kicad_pcb]
2026-01-30 Added PCA9685 servo controller
    [CITADEL 2026.kicad_pcb, CITADEL 2026.kicad_sch]
2026-01-30 Fixed typo with stepper daughter connector
    [CITADEL 2026.kicad_pcb]
2026-01-31 Updated servo connectors and ESC comms
    [CITADEL 2026.kicad_pcb, CITADEL 2026.kicad_sch]
2026-01-31 Updated servo connectors
    [CITADEL 2026 Daughter.kicad_pcb, CITADEL 2026 Daughter.kicad_sch]
2026-01-31 Added I²C pullups
    [CITADEL 2026.kicad_pcb, CITADEL 2026.kicad_sch]
2026-02-06 Changed back plane to GND and added 5V zone
    [CITADEL 2026 Daughter.kicad_pcb]
2026-02-06 Updated PCB as per review feedback
    Changed routing of vibration motor trace and removed unused EPS32 pin
    [CITADEL 2026.kicad_pcb]
2026-02-06 Changed 5V trace for PCA9685
    [CITADEL 2026.kicad_pcb]
2026-02-07 Updated PCB as per feedback
    [CITADEL 2026.kicad_pcb]
2026-02-07 Aligned vias to grid
    [CITADEL 2026 Daughter.kicad_pcb]
2026-02-07 Changed trace for vibration motor
    [CITADEL 2026.kicad_pcb]
2026-02-10 Updated ESP32 Footprint
    [CITADEL 2026.kicad_pcb]
2026-02-10 Updated Vias
    [CITADEL 2026.kicad_pcb]
2026-02-11 Moved vias away from trace
    [CITADEL 2026.kicad_pcb]
2026-03-19 Changed layout to support new linear actuators
    [CITADEL 2026 Daughter.kicad_pcb, CITADEL 2026 Daughter.kicad_sch]
2026-03-20 Updated reference names
    [CITADEL 2026 Daughter.kicad_pcb, CITADEL 2026 Daughter.kicad_sch]
2026-03-20 Created CITADEL V2
    [CITADEL 2026 V2.kicad_pcb, CITADEL 2026 V2.kicad_sch]
2026-03-20 Moved V1 files to dedicated folder
    [CITADEL 2026.kicad_pcb, CITADEL 2026.kicad_sch]
2026-03-21 Cleaned up a trace
    [CITADEL 2026 V2.kicad_pcb]
2026-03-23 Removed stepper drivers
    [CITADEL 2026 V2.kicad_sch]
2026-03-23 Removed steppers and updated silkscreen names
    [CITADEL 2026 V2.kicad_pcb]
2026-03-25 Removed daughter board
    Board was no longer needed, connections were moved to main CITADEL board
    [CITADEL 2026 Daughter.kicad_pcb, CITADEL 2026 Daughter.kicad_sch]
2026-03-25 Changed linear actuator connectors
    Removed the connector for the daughter board and moved the 1x2 molex connectors onto main board
    [CITADEL 2026 V2.kicad_pcb, CITADEL 2026 V2.kicad_sch]
2026-04-16 FAERIE 2026 V1
    FAERIE April 15, 2026
    [FAERIE.kicad_pcb, FAERIE.kicad_sch]
2026-04-16 Updated values for CAN resistors and caps
    [CITADEL 2026 V2.kicad_sch]
2026-04-21 FAERIE 2026 r1.01
    Changed Sparkmax PWM 1 and 2 from XT-30 connectors to Molex
    [FAERIE.kicad_pcb, FAERIE.kicad_sch]
2026-04-22 FAERIE 2026 r1.02
    Built ground plane for change to Sparkmax PWM Molex connectors
    [FAERIE.kicad_pcb, FAERIE.kicad_sch]
2026-04-22 LANCE 2026 r1
    Rename of FAERIE r1.02 to LANCE r1
    [LANCE.kicad_pcb, LANCE.kicad_sch]
2026-04-22 LANCE 2026 r1.01
    A1 Pin 8 pad connection changed to solid
    [LANCE.kicad_pcb, LANCE.kicad_sch]
2026-05-01 LANCE 2026 r1.02
    Changed nSLEEP on MP6603 (x2) and on MPQ6612A to 3.3V, moved CAN_TX to non-strapping pin 9 on ESP32, changed SHT30 connector to I2C connector convention used on Core and Antenna, moved SHT30 connector to bottom right, rerouted 5V trace, added 63uF (x4) bank to battery trace to lessen voltage sag, grouped ground vias, and added Gerbers/Drill files
    [LANCE-B_Cu.gbl, LANCE-B_Mask.gbs, LANCE-B_Paste.gbp, LANCE-B_Silkscreen.gbo, LANCE-Edge_Cuts.gm1, LANCE-F_Cu.gtl, LANCE-F_Mask.gts, LANCE-F_Paste.gtp]
2026-05-26 feat!: remove faerie
    [FAERIE.kicad_pcb, FAERIE.kicad_sch]
